mayankamedhe/Sensors-and-Motor-Control-Lab-TSP05/(commit log)

2026-11-07 Code for distance based IR sensor motor control on arduino with ESP32 mapping readme
2026-11-07 Add flex sensor control for RC servoAdd flex sensor and servo sketch
    This code implements a flex sensor to control an RC servo using an Arduino Uno R3. It includes setup for reading the flex sensor and adjusting the servo position based on the sensor's readings.
    [flex_servo.ino]
2026-11-07 Document flex sensor and servo wiring
2026-11-07 Link flex sensor and servo contribution
2026-11-07 Move servo contribution to its own branch
2026-11-07 Restore README after moving servo work
2026-11-07 Clarify the servo test result
2026-11-07 Add VL53L5CX bring-up test for ESP32
    Standalone PlatformIO project (esp32dev, SparkFun VL53L5CX library) that
    prints the 8x8 distance grid in raw array order, marks invalid zones
    (target_status not 5/9) as "----", and reports the nearest zone's row/col
    for orientation testing. Verified on hardware: frames at ~15 Hz.
2026-11-07 Add ToF swipe-gesture detection for stepper control
    Detects left/right hand swipes with the VL53L5CX in 4x4 mode at 30 Hz:
    - background calibration over the first 30 frames to ignore desk/wires
    - hand zones = valid, 30-400 mm, >=100 mm closer than background
    - hand x = 1/distance-weighted mean column
    - swipe = >=1.5 columns moved within 60-1500 ms, 600 ms cooldown
    Prints SWIPE,LEFT / SWIPE,RIGHT and calls onSwipe(+-1), the hook for
    the stepper move. Tested on hardware: both directions detected correctly
    with MIRROR_X = false.
    [main.cpp]
2026-11-07 Add ESP32 EasyDriver stepper control
2026-11-07 Document ESP32 system pinout
2026-11-07 Restore Mayanka's IR distance sketch dropped by the merges
    main deleted IR_distance.ino and readme_IR_distance.md after they were
    added, so merging the branches that still had the unchanged files kept
    the deletion. Restore both from origin/arduino-uno-motor-IR.
2026-11-07 Add stepper bring-up sketch for ESP32 + EasyDriver
    Turns the SM-42BYG011-25 one revolution each way at 1/8 microstepping
    (1600 steps/rev) and prints requested vs. actual angle.
2026-11-07 Integrate all sensors and motors into one ESP32 firmware
    firmware/tsp05_main is a PlatformIO project that runs everything in one
    program, built from each teammate's sketch:
    - Sharp IR -> DC motor speed (Mayanka), thresholds converted to mV
    - Flex sensor -> servo with EMA filter (BillyChern), via ESP32Servo
    - VL53L5CX swipe -> stepper +/-45 deg (Mayank's detector, Rai's
    non-blocking stepper driver); the ToF runs in a FreeRTOS task on
    core 0 so I2C reads and the firmware upload never stall stepping
    - Debounced button and 'mode' command toggle GUI/SENSOR mode
    - Serial commands for GUI control and name:value telemetry
    Pins moved off strapping pins (0, 2, 15) and ADC2 (14); see
    docs/PINOUT.m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
    [config.h, flex_servo.cpp, flex_servo.h, ir_dc.cpp, ir_dc.h, main.cpp]
2026-11-07 Match firmware pins to the team's wiring
    The board is wired per Rai's pinout: DC motor ENA/IN1/IN2 on GPIO
    15/2/0 and Sharp IR on GPIO 14. Use those pins in config.h and the
    Wokwi diagram instead of 18/19/23 and 34.
    GPIO 0, 2 and 15 are strapping pins, so the DC motor can run during
    reset/flashing and the L298 board may block uploads. GPIO 14 is ADC2,
    which is fine without Wi-Fi. Both risks are documented in PINOUT.md.
    [config.h]
2026-11-07 Add follow-the-hand ToF style for the stepper
    'tof follow' makes the stepper angle track the hand's left-right
    position (far left -> -90 deg, far right -> +90 deg), with an EMA on
    hand x and a 2 deg deadband. 'tof swipe' (default) keeps Mayank's
    +/-45 deg per swipe. When the hand leaves, the stepper holds.
    stepper::moveToDegrees() retargets an absolute move without
    restarting step timing when the direction is unchanged.
    The simulated ToF now reports a continuous hand x: a hand between two
    columns is drawn in both with distances that make the weighted mean
    land on the slider position, so the real tracking code runs unchanged.
2026-11-07 Add tof_state and step_moving to firmware telemetry
    The ROS 2 bridge needs to know when the ToF is ready and whether the
    stepper is still moving. Also expose the Wokwi serial port over
    RFC2217 (port 4000) so the bridge can connect to the VS Code simulator,
    and ignore ROS 2 build output.
2026-11-07 Add ROS 2 serial bridge package tsp05_bridge
    serial_bridge is the single node that owns the ESP32 serial port. It
    parses the firmware's key:value telemetry into /tsp05/... state topics
    (mode, IR, flex raw/filtered, ToF hand and swipes, stepper, servo, DC)
    and turns /tsp05/cmd/... topics into firmware serial commands.
    It reconnects automatically and accepts pyserial URLs, so it also
    works with the Wokwi simulator via rfc2217://localhost:4000.
    fake_esp32 speaks the same protocol on a pseudo-terminal, so the
    bridge and GUI can be developed without hardware. protocol.py has no
    ROS dependency and is covered by pytest.
    Tested end to end with fake_esp32: state topics publish, and stepper,
    servo a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
    [fake_esp32.py, protocol.py, serial_bridge.py]
2026-11-08 Make the sensor-driven stepper speed adjustable
    Swipes ran at 30 rpm and follow mode at 60 rpm. Both now use one
    speed, default 60 rpm, that 'speed <rpm>' changes at runtime (1-120)
    so it can be tuned on the bench without reflashing. GUI moves keep
    their own 'step <deg> <rpm>' argument.
2026-11-08 Run the stepper at 180 rpm with an acceleration ramp
    The stepper was too slow at 60 rpm. Default speed is now 180 rpm for
    both sensor-driven moves and GUI 'step' commands, and the limit is
    300 rpm.
    A stepper started directly at 180 rpm tends to stall and buzz, so
    moves now start and end at 60 rpm and ramp at 6000 rpm/s
    (v^2 = v0^2 + 2a per step, decelerating when the remaining steps
    equal the stopping distance). A 45 deg swipe takes ~55 ms instead of
    125 ms at the old 60 rpm.
    [main.cpp, stepper_ctrl.cpp, stepper_ctrl.h]
2026-11-08 Add a run guide for Ubuntu and macOS
    docs/HOW_TO_RUN.md walks through installing PlatformIO, cloning the
    integration branch, finding the ESP32 port, flashing, the serial
    commands, and the errors hit on the first run (running pio in the repo
    root, the Arduino Serial Monitor holding the port). Ubuntu steps are
    verified; macOS steps use the same tools with Mac install commands and
    port names.
2026-11-09 Add rqt control panel for the TSP05 system
    New ROS 2 package tsp05_gui: a custom rqt plugin that talks only to the
    tsp05_bridge topics.
    - Top bar: data indicator, current mode, GUI/SENSOR mode buttons, ToF
    swipe/follow selector, STOP motors
    - Sensors: IR voltage, flex bend %, ToF hand position and state, live
    plots of flex raw vs filtered (filter demo) and IR output
    - Motors: stepper relative move with the actual angle shown, servo
    slider with both limits, DC PWM slider; greyed out in SENSOR mode
    because the firmware ignores motion commands then
    - Firmware event log
    ROS callbacks reach the widgets through a Qt signal, so updates happen
    on the GUI thread. system.launch.py starts the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
    [main.py, panel.py, panel_widget.py]
2026-11-10 fix(tsp05_bridge): read full buffer in serial_bridge to support socket:// URLs
    [serial_bridge.py]
2026-11-12 IR -> DC motor: stay off until a hand is detected, speed up as it gets closer
    The old linear map (490-2930 mV -> PWM 0-255) let the motor creep in the
    friction deadband and had no notion of "nothing in view".
    - Tuned for the Sharp GP2Y0A02YK (20-150 cm)
    - EMA filter on the IR voltage (ir_filt_mv)
    - Detection with hysteresis: on at 900 mV (~80 cm), off below 750 mV (~100 cm)
    - On detection the motor jumps to MIN_RUN_PWM (90, above the SPG30 deadband)
    and ramps linearly to 255 at 2500 mV (~20 cm)
    - Telemetry adds ir_filt_mv and ir_detect; fake ESP32 and Wokwi bundle updated
2026-11-12 GUI: physical units, IR raw vs filtered, DC position/velocity controls
    Brings the rqt panel in line with the TSP05 GUI requirements.
    - Sensors shown in physical units, converted in the bridge (units.py):
    IR distance in cm (GP2Y0A02 model mV = k/(cm+d0)+c, datasheet fit as
    default until the team's own fit is in), flex bend angle in degrees,
    ToF hand bearing in degrees plus distance and sideways offset in mm
    - IR raw vs filtered live plot (uses the firmware's ir_filt_mv), detection state
    - Stepper: last move requested vs actual angle, parsed from the firmware reply
    - DC motor: encoder position/speed display, relative-degrees move and
    velocity (rpm) controls in either direction, via ne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
    [fake_esp32.py, panel_widget.py, protocol.py, serial_bridge.py, units.py]
2026-11-12 Transferred arduino code to esp32
2026-11-12 initial plots
    [ir_run1.csv]
2026-11-12 Updated member contribution
    [ir_run1_clean.csv]
2026-11-13 DC motor: quadrature encoder + PID position and velocity control
    Closes the last DC requirement: GUI-commanded relative position (degrees)
    and velocity (rpm), either direction, with encoder feedback and PID.
    - SPG30E Hall encoder on GPIO 16 (A, blue) / 17 (B, purple), open-drain
    outputs with pull-ups to 3.3 V; x4 decoding in an interrupt
    - dcdeg <deg>: position PID (derivative on measurement, integral only near
    the target, deadband offset), reports final position and error
    - dcrpm <rpm>: feedforward + PI speed control, 0 = stop
    - Runaway protection: stops the motor if the encoder direction is reversed
    - dcenc [zero] to measure counts per turn, dcgain to tune live
    - Telemetry dc_deg / dc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
    [config.h, dc_pid.cpp, dc_pid.h, main.cpp]
2026-11-13 DC motor: constants for the SPG30E-60K (720 counts/rev, ~65 rpm max)
    Our motor is the 60:1 version, not 30:1: 12 counts per motor turn x 60 = 720 counts per output turn, and the output shaft tops out around 60-70 rpm. Velocity feedforward and the GUI rpm limit updated to match. Both still to be confirmed with dcenc and dc 255.
2026-11-13 DC encoder: dcenc shows live A/B pin states, dcenc watch wiring check
    dcenc now prints the current level of both encoder pins. dcenc watch logs every A/B change for 5 s while the shaft is turned by hand and says NO SIGNAL if nothing changes, to separate wiring problems from counting problems.
    [main.cpp]
